rosalindfranklininstitute/DeltaBot/Images/MotorCouplingNut.png

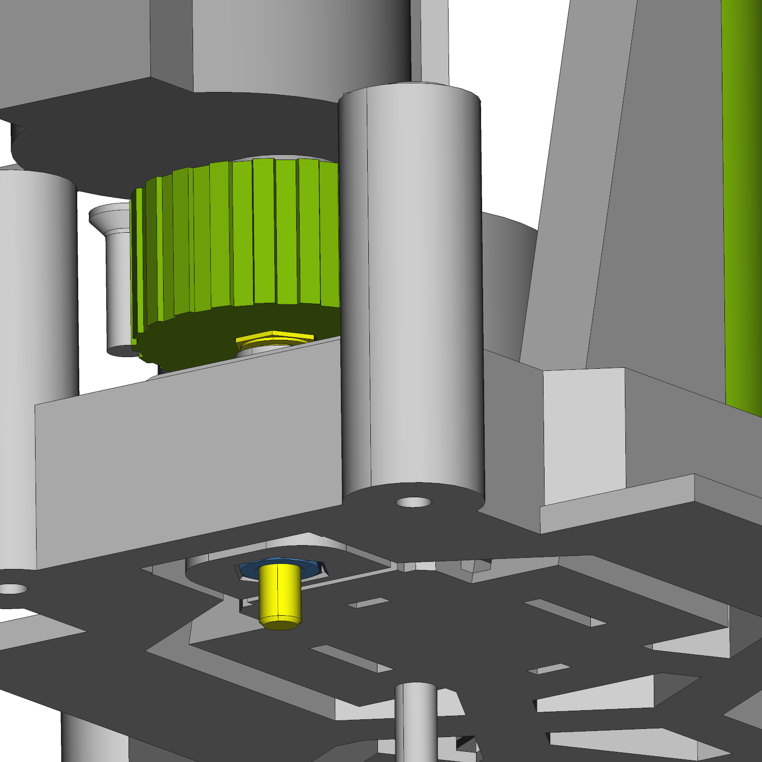
Images/MotorCouplingNut.png
