rosalindfranklininstitute/DeltaBot/README.md

# DeltaBot
Print and build instructions for the Franklins Delta Robot for sample scanning.
