rosalindfranklininstitute/DeltaBot/Images/Deltabot.png

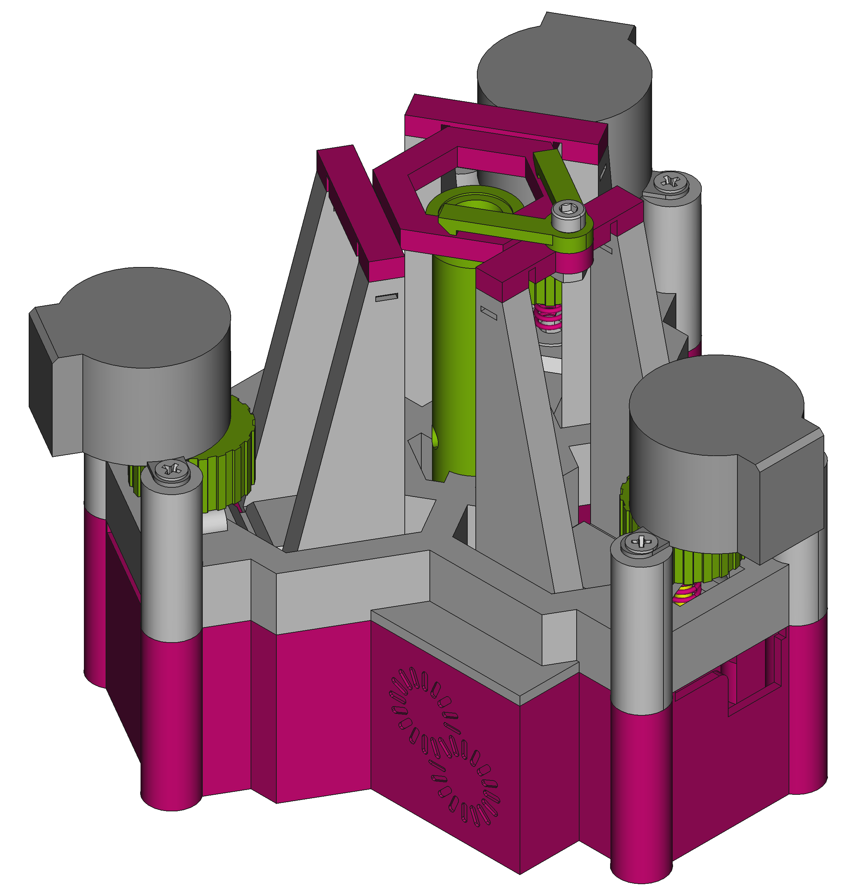
Images/Deltabot.png
