rosalindfranklininstitute/DeltaBot/Images/Deltabot_Diagonal.png

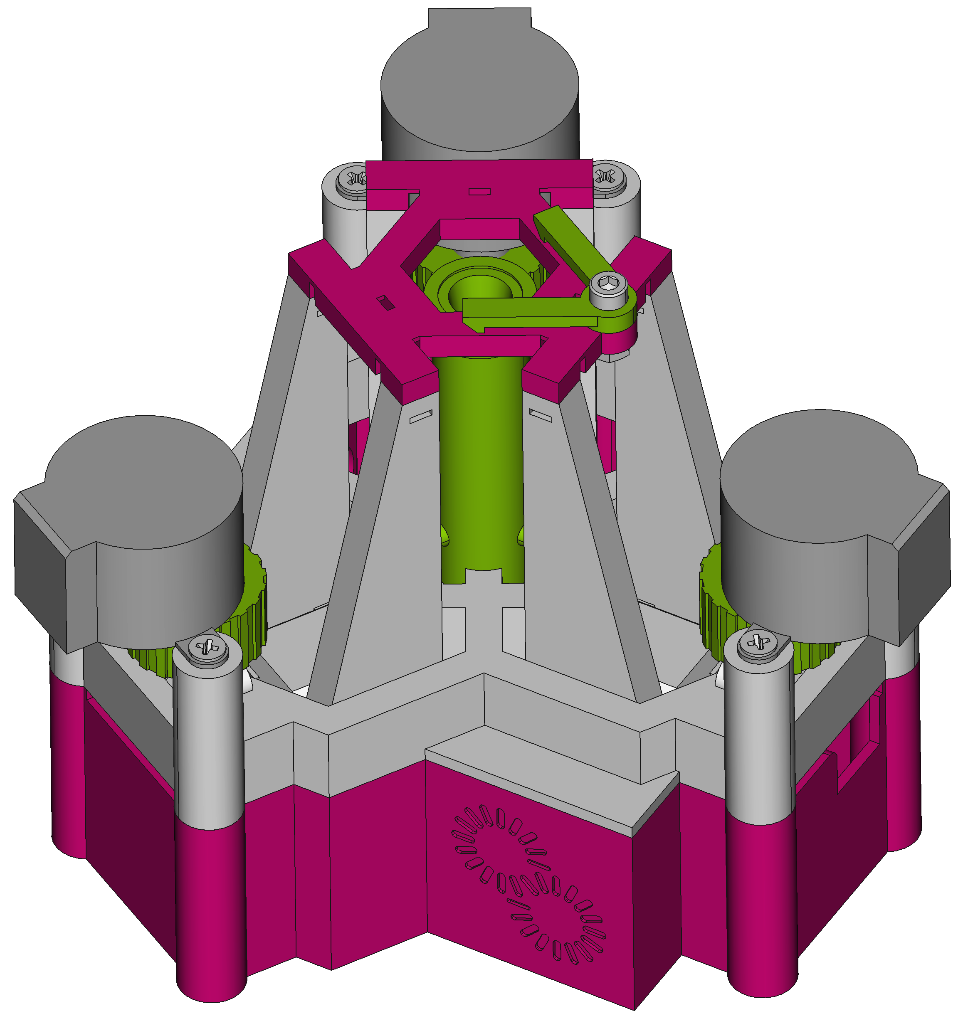
Images/Deltabot_Diagonal.png
