rosalindfranklininstitute/DeltaBot/Images/Deltabot_Side1.png

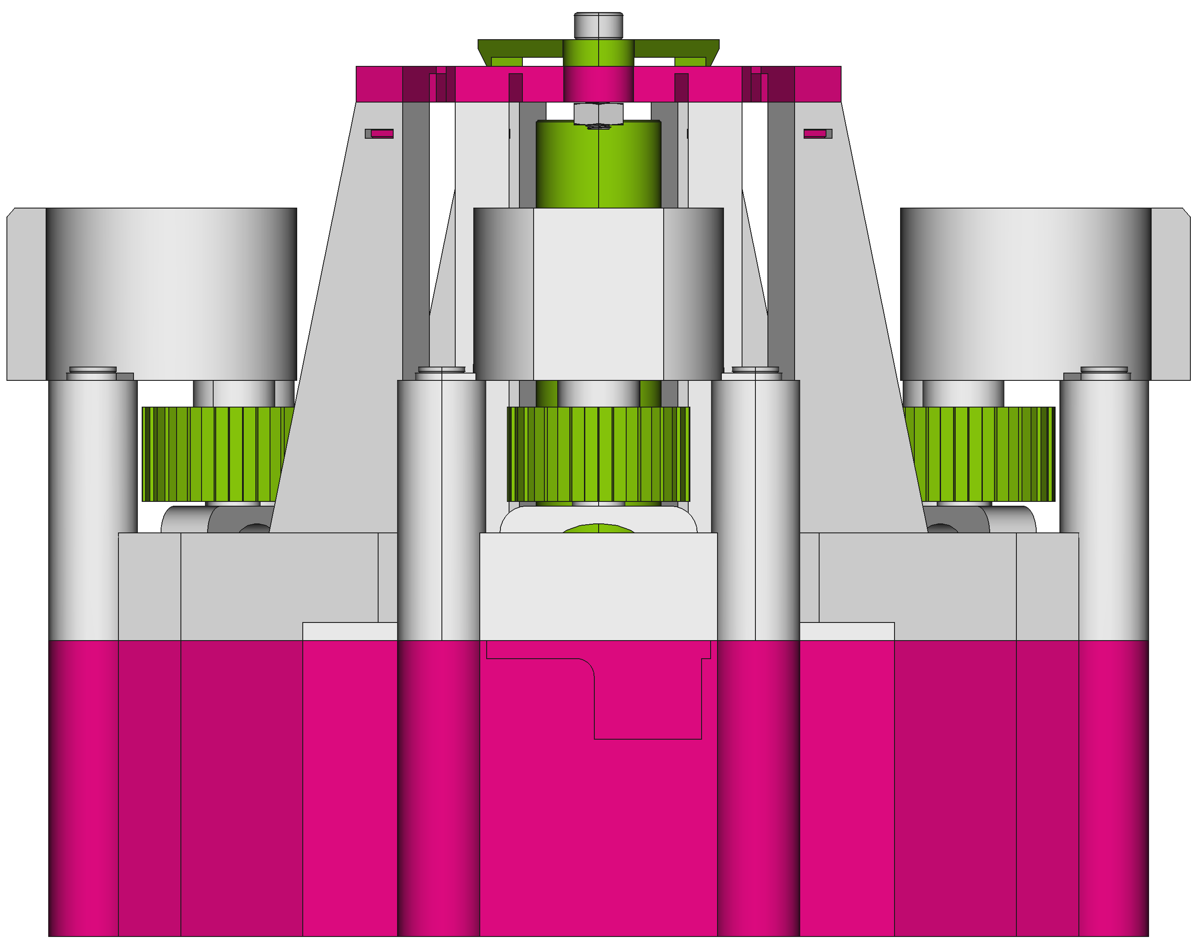
Images/Deltabot_Side1.png
