rosalindfranklininstitute/DeltaBot/Images/Deltabot_Side2.png

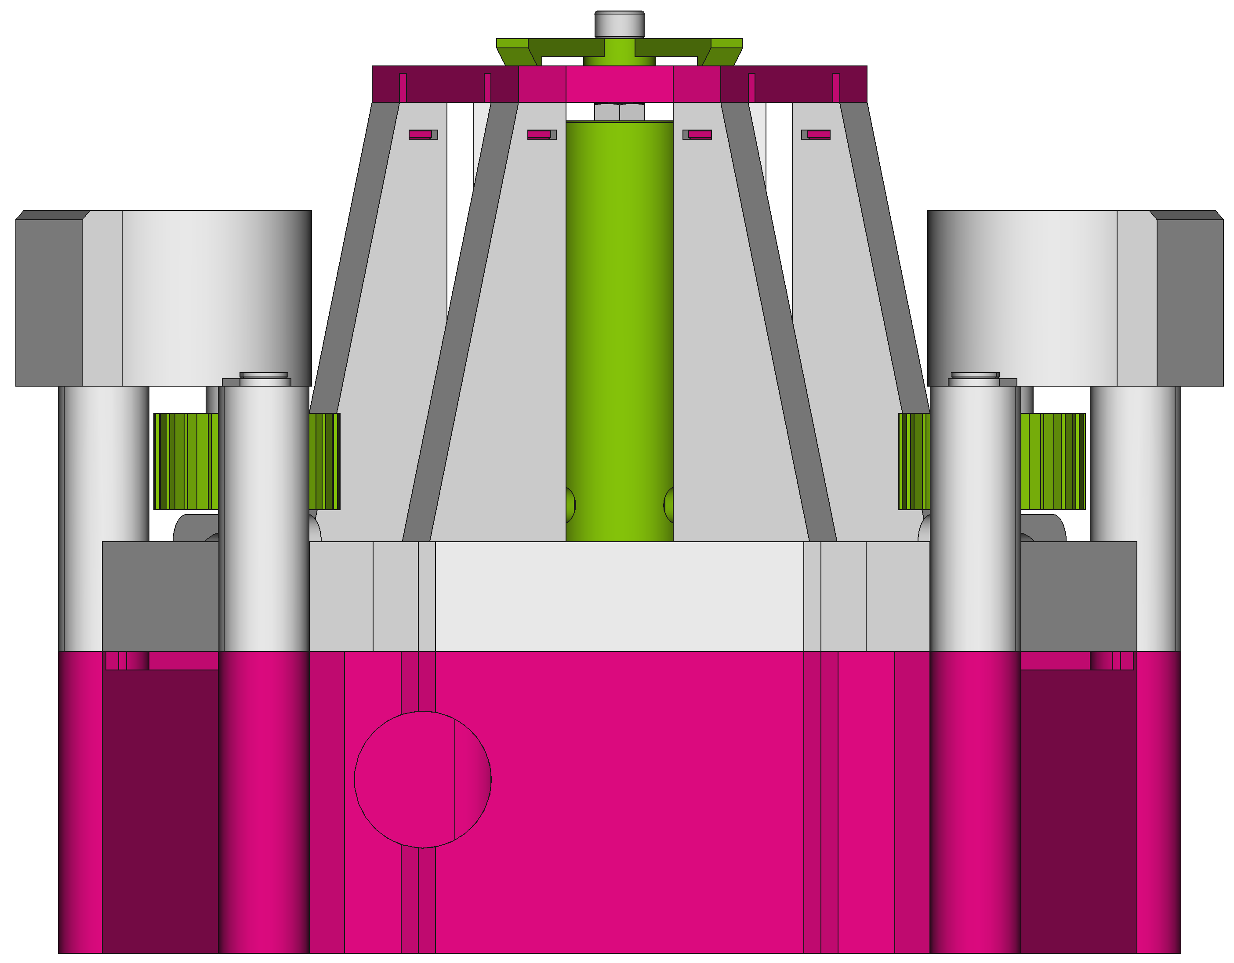
Images/Deltabot_Side2.png
