rosalindfranklininstitute/DeltaBot/Images/Deltabot_Top.png

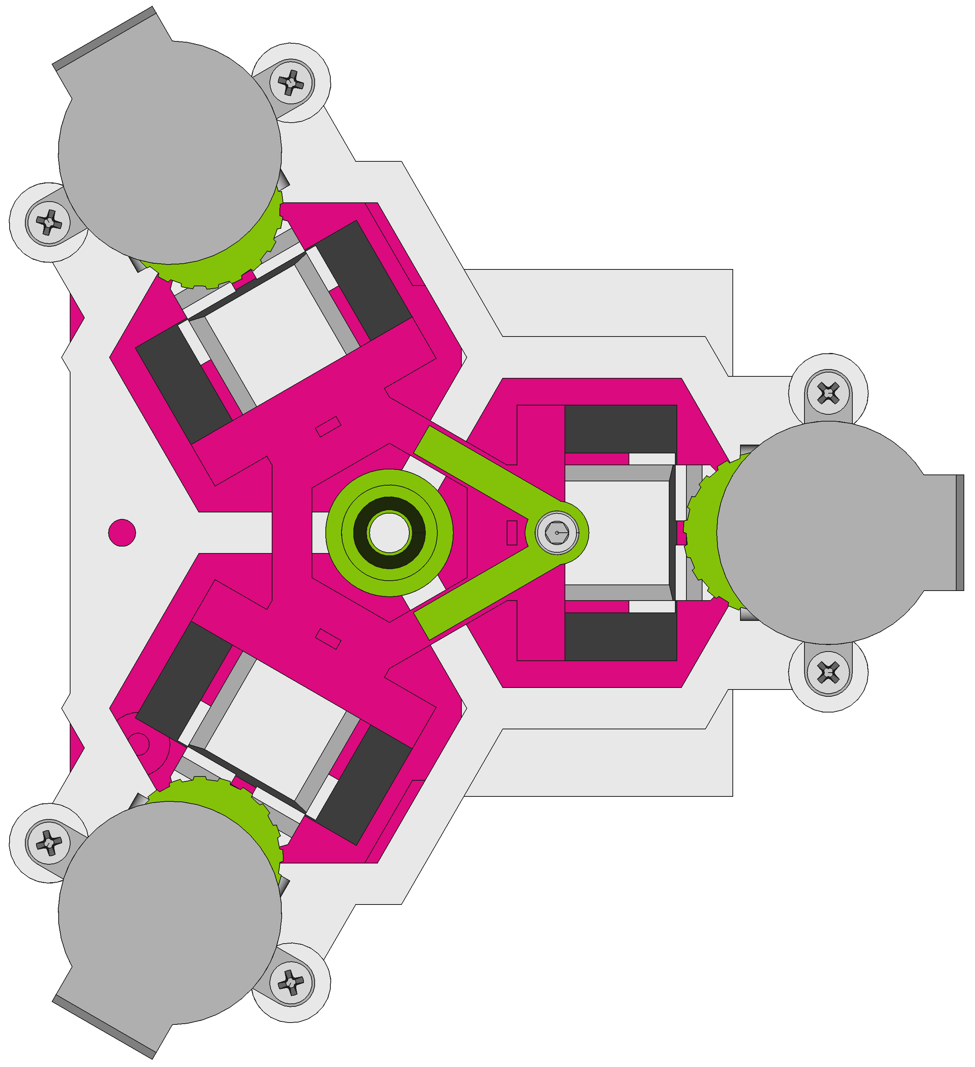
Images/Deltabot_Top.png
