rosalindfranklininstitute/DeltaBot/Images/ExplodedView2.png

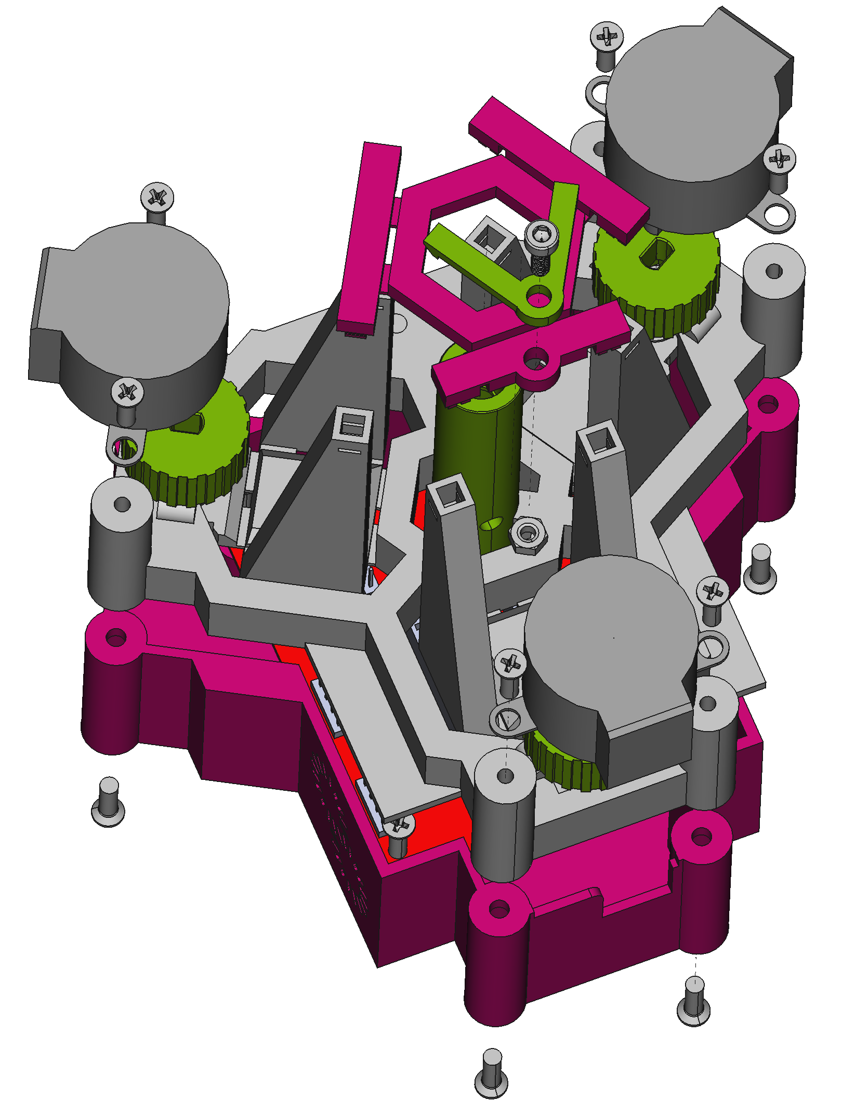
Images/ExplodedView2.png
