rosalindfranklininstitute/DeltaBot/Images/ExplodedView.png

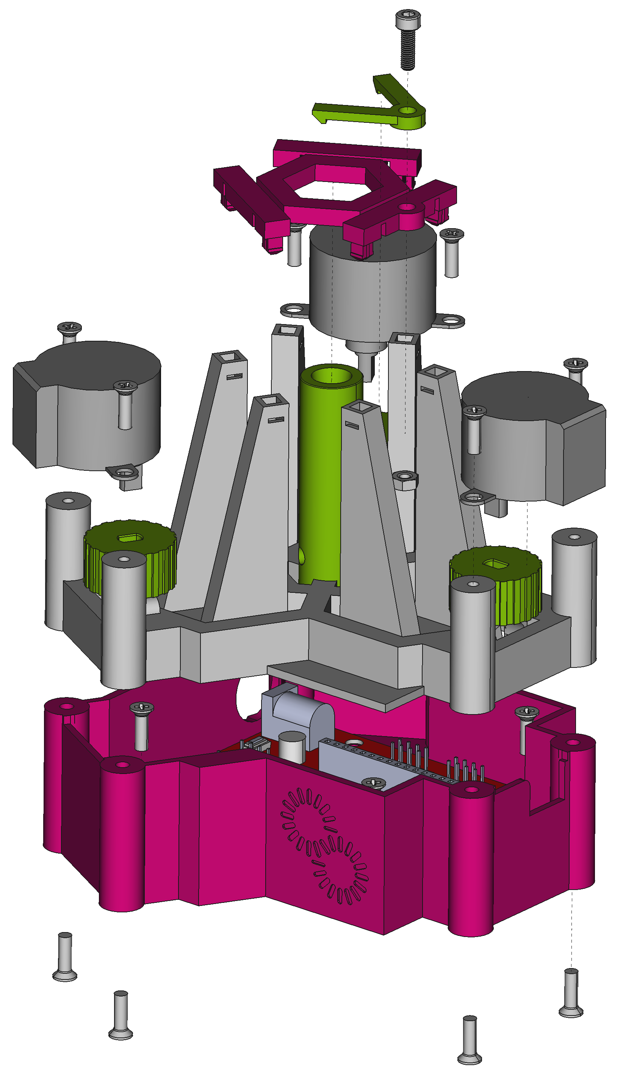
Images/ExplodedView.png
