rosalindfranklininstitute/DeltaBot/Images/PressNut.png

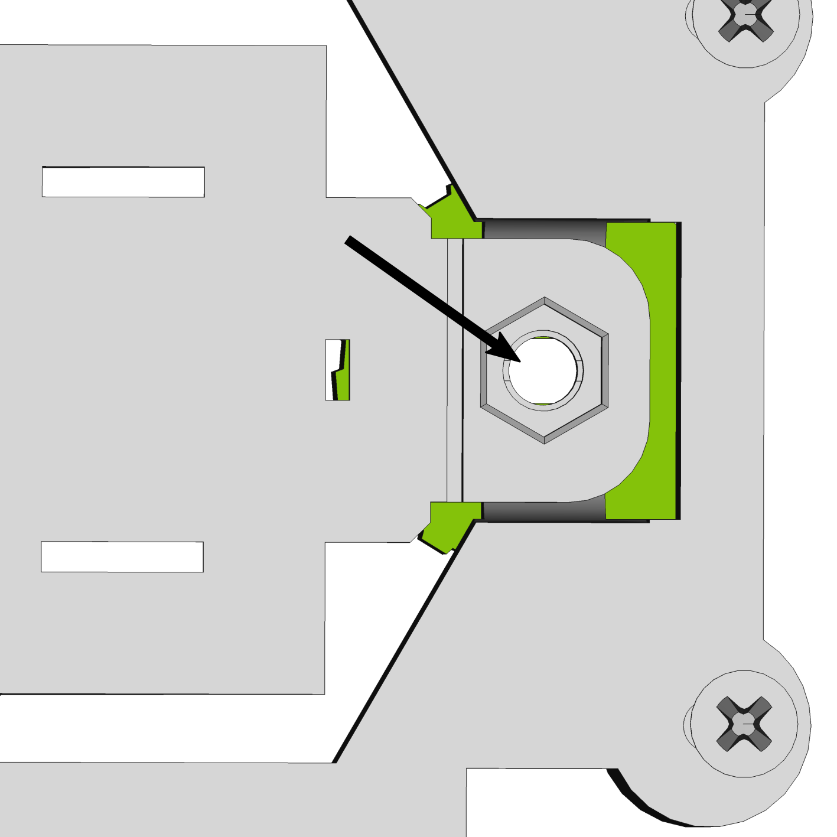
Images/PressNut.png
