rosalindfranklininstitute/DeltaBot/STL/DeltaBot_Bottom_V2.stl

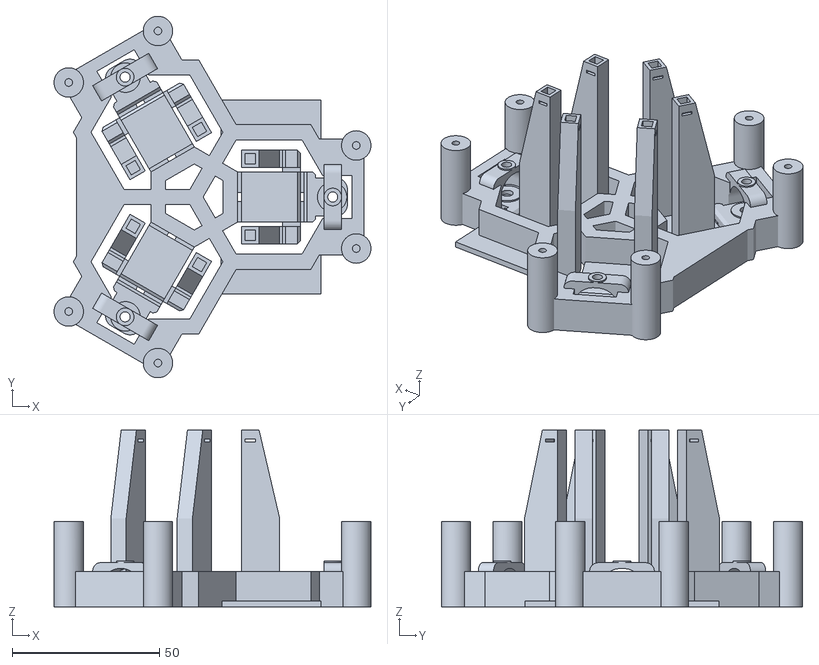
[picture p10: CAD file, 2020-12-10]
STL/DeltaBot_Bottom_V2.stl
107.7 x 122.8 x 60.0
