rosalindfranklininstitute/DeltaBot/STP/Base_Extended.stp

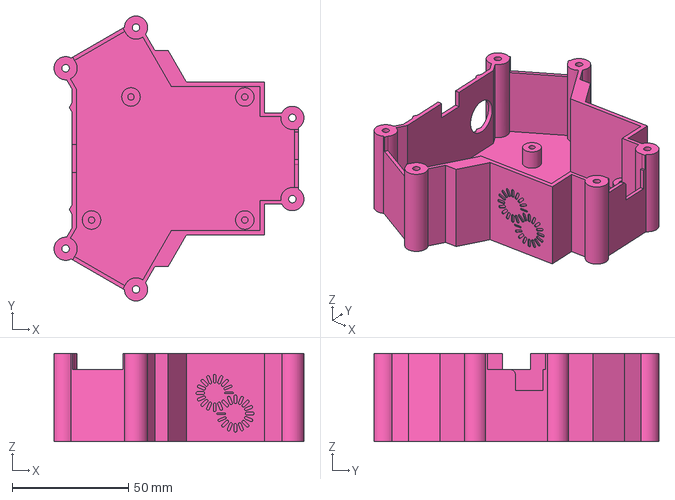
[picture p11: CAD file, 2020-12-11]
STP/Base_Extended.stp
107.6 x 122.7 x 38.0 mm
