rosalindfranklininstitute/DeltaBot/STL/SlideClip.stl

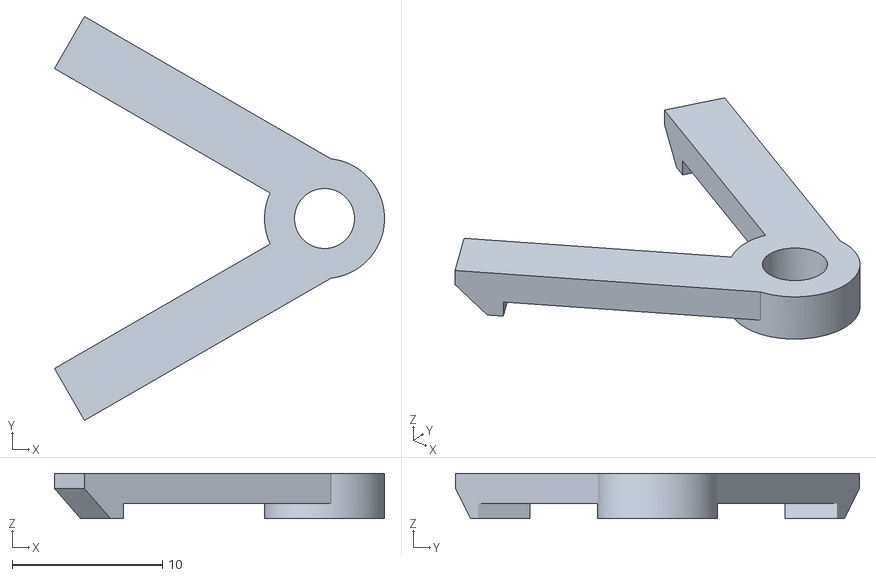
[picture p12: CAD file, 2020-11-03]
STL/SlideClip.stl
22.0 x 26.9 x 3.00
