rosalindfranklininstitute/DeltaBot/STL/ThumbWheel.stl

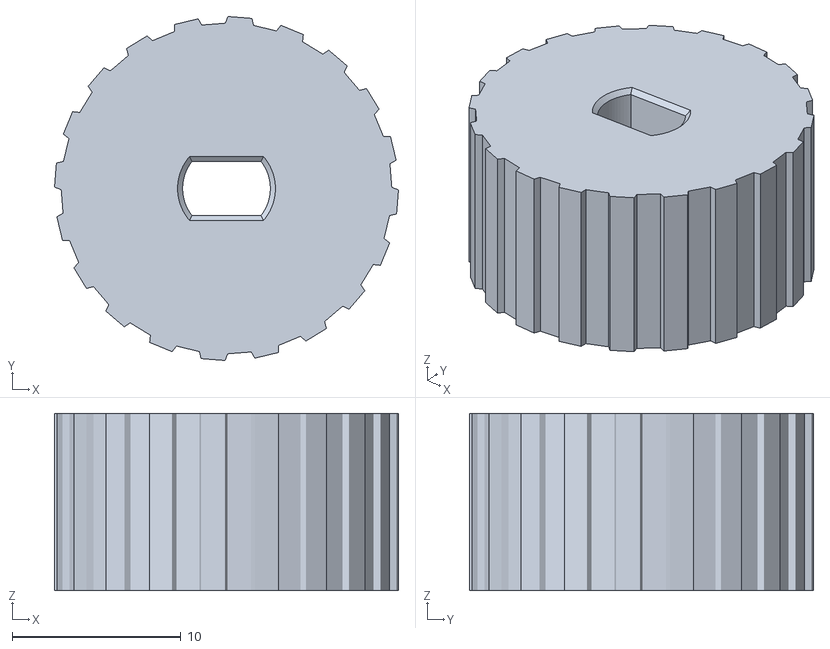
[picture p13: CAD file, 2020-11-03]
STL/ThumbWheel.stl
20.4 x 20.4 x 10.5
