rosalindfranklininstitute/DeltaBot/STL/Base.stl

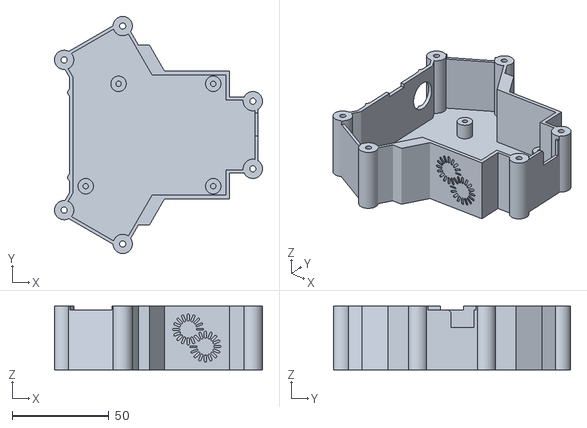
[picture p14: CAD file, 2020-11-03]
STL/Base.stl
107.7 x 122.8 x 33.0
