rosalindfranklininstitute/DeltaBot/STL/LED_Post.stl

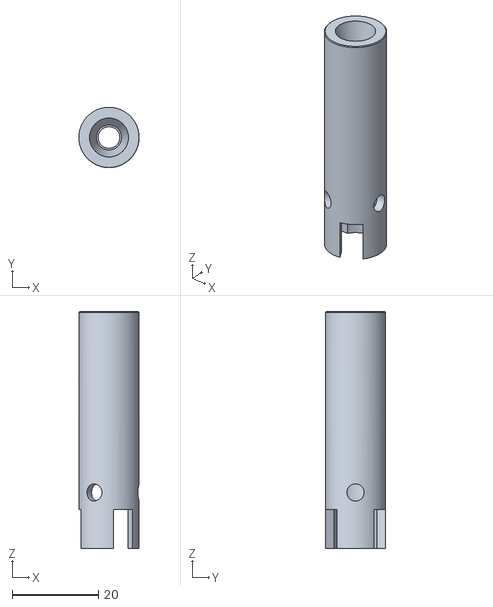
[picture p15: CAD file, 2020-11-03]
STL/LED_Post.stl
14.0 x 14.0 x 55.0
