rosalindfranklininstitute/DeltaBot/STL/DeltaBot_Top.stl

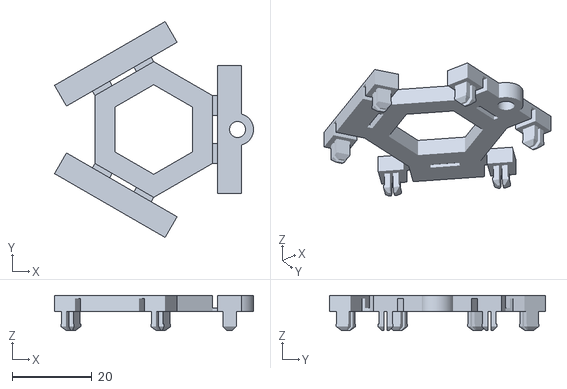
[picture p16: CAD file, 2020-11-03]
STL/DeltaBot_Top.stl
49.9 x 54.1 x 8.80
