rosalindfranklininstitute/DeltaBot/STL/DeltaBot_Bottom.stl

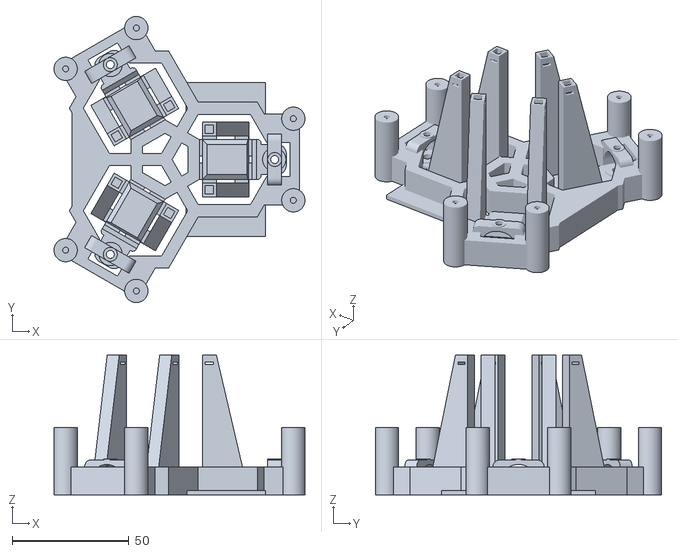
[picture p17: CAD file, 2020-11-03, an earlier design]
STL/DeltaBot_Bottom.stl
107.7 x 122.8 x 60.0
