rosalindfranklininstitute/DeltaBot/(list of files, cad)

Other CAD files:
STP/DeltaBotV2.stp
STL/Base_Extended.stl
