rosalindfranklininstitute/DeltaBot/(commit log)

2020-11-03 Increased resolution for STL files
    [Base.stl, DeltaBot_Bottom.stl, DeltaBot_Top.stl, LED_Post.stl, SlideClip.stl, ThumbWheel.stl]
2020-12-10 Increased Z range
    [DeltaBotV2.stp, DeltaBot_Bottom_V2.stl]
2020-12-11 Added extended base for easier installation
    [Base_Extended.stl, Base_Extended.stp]
